preetopritam/NeuroLIF-SKY130/results/pvt/pvt_27point_summary.csv

corner | vdd_V | temp_C | simulation_complete | weight_00_silent | weight_11_fires | weight_11_valid_spike | nondecreasing_response | spikes_00 | spikes_01 | spikes_10 | spikes_11 | rate_00_Hz | rate_01_Hz | rate_10_Hz | rate_11_Hz | spike11_fraction_VDD | point_pass
ff | 1.62 | -40.0 | True | True | True | True | True | 0 | 16 | 39 | 60 | 0.0 | 42105.26315789473 | 102631.57894736841 | 157894.73684210525 | 1.010903 | True
ff | 1.62 | 27.0 | True | True | True | True | True | 0 | 4 | 33 | 62 | 0.0 | 10526.315789473683 | 86842.1052631579 | 163157.8947368421 | 1.014752 | True
ff | 1.62 | 125.0 | True | True | True | True | True | 0 | 0 | 0 | 11 | 0.0 | 0.0 | 0.0 | 28947.36842105263 | 1.008452 | True
ff | 1.8 | -40.0 | True | True | True | True | True | 0 | 18 | 41 | 65 | 0.0 | 47368.42105263157 | 107894.73684210525 | 171052.63157894736 | 1.030972 | True
ff | 1.8 | 27.0 | True | True | True | True | True | 0 | 4 | 33 | 63 | 0.0 | 10526.315789473683 | 86842.1052631579 | 165789.4736842105 | 1.019488 | True
ff | 1.8 | 125.0 | True | True | True | True | True | 0 | 0 | 0 | 11 | 0.0 | 0.0 | 0.0 | 28947.36842105263 | 1.008106 | True
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
