preetopritam/NeuroLIF-SKY130/results/variation/variation_13case_summary.csv

condition | parameter | multiplier | cmem_F | iref_A | vleak_V | simulation_complete | weight_00_silent | weight_11_fires | weight_11_valid_spike | nondecreasing_response | spikes_00 | spikes_01 | spikes_10 | spikes_11 | rate_00_Hz | rate_01_Hz | rate_10_Hz | rate_11_Hz | spike11_fraction_VDD | condition_pass
cmem_0.90x | cmem | 0.9 | 4.5e-12 | 1e-07 | 0.5 | True | True | True | True | True | 0 | 17 | 42 | 70 | 0.0 | 44736.84210526315 | 110526.31578947368 | 184210.52631578947 | 1.018072 | True
cmem_0.95x | cmem | 0.95 | 4.75e-12 | 1e-07 | 0.5 | True | True | True | True | True | 0 | 16 | 41 | 68 | 0.0 | 42105.26315789473 | 107894.73684210525 | 178947.3684210526 | 1.018091 | True
cmem_1.05x | cmem | 1.05 | 5.25e-12 | 1e-07 | 0.5 | True | True | True | True | True | 0 | 16 | 41 | 62 | 0.0 | 42105.26315789473 | 107894.73684210525 | 163157.8947368421 | 1.017956 | True
cmem_1.10x | cmem | 1.1 | 5.5e-12 | 1e-07 | 0.5 | True | True | True | True | True | 0 | 15 | 38 | 61 | 0.0 | 39473.68421052631 | 100000.0 | 160526.31578947368 | 1.018758 | True
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
