preetopritam/NeuroLIF-SKY130/(notices)

Notices in the files:
README.md:
License: MIT
